42tg/Gartensauna/README.md

# Gartensauna – CAD & Selbstbau

Planung einer Gartensauna am Standort des bestehenden Holzunterstands. Dieses Repository ist die zentrale Quelle für Maße, Entscheidungen, CAD-Modelle, Bauaufbau, Kosten und Aufgaben.

## Verbindlicher Planungsstand (13.11.2026)

**Der alte Holzunterstand wird abgerissen; geplant wird ein Neubau. Seine 1,93 m Höhe begrenzen den Neubau nicht. Beschlossen sind 2,20 m lichte Innenhöhe, gemessen von Oberkante Fertigboden bis Unterkante fertiger Decke.**

Mit dem aktuellen 281-mm-Dachaufbau liegt die Dachoberkante bei 2,481 m über Fertigboden. Einschließlich 120 mm Bodenaufbau: 2,601 m von Bodenunterseite bis Dachoberkante, ohne Fundamente und zusätzliches Dachgefälle. Gelände- und Genehmigungshöhe bleiben zu bestimmen. Maßgebend: [Entscheidung 0012](docs/decisions/0012-neubau-innenhoehe.md).

## Gemessener Altbestand (25.10.2026)
- Bestehender Unterstand: **3,20 m lang**, **1,70 m tief** (links, Mitte und rechts), **1,93 m hoch** (gemessener Wert; Messpunkt noch zu klären).
- Eine Erweiterung der Tiefe auf **bis zu ca. 2,00 m** ist möglich.
- Der Unterstand wird **abgerissen**. Bestandsmaße dienen der Standortreferenz, nicht als maximale Neubauhöhe.
- Kein Umbau des Steinturms.
- Vorhandene Fotos zeigen einen Holzunterstand mit Pultdach, Pfosten, OSB-Teilen und Holzlager.

## Historischer Entwurf V1 (nicht maßgebend für den aktuellen Neubau)
Für CAD V1 werden **3,20 × 2,00 m** und eine **vordere Höhe von 2,30 m** als *Annahmen* verwendet, nicht als beschlossene Endmaße. Saunabänke, Tür und Ofen sind Platzhalter.

## Vorgehen
1. Bestandsmaße und Geländesituation vervollständigen.
2. Parametrisches CAD-Modell mit Varianten erstellen.
3. Grundriss, Ofen, Bänke und Lüftung festlegen.
4. Wand-, Dach- und Bodenaufbau bauphysikalisch prüfen.
5. Statik, Brandschutz, Elektroinstallation und lokale Anforderungen prüfen.
6. Stückliste, Kosten und Bauablauf ausarbeiten.

Siehe [Messwerte](docs/measurements.md), [Anforderungen](docs/requirements.md), [Entscheidungen](docs/decisions/README.md) und [Aufgaben](https://github.com/42tg/Gartensauna/issues).

## Visuelle Planung

Grundriss

Explosionsansicht

Wandaufbau

[Alle Zeichnungen](docs/visuals/README.md) · [Parametrisches OpenSCAD-Modell](cad/sauna.scad)

**Hinweis:** Das OpenSCAD-Modell ist ein neues Konzeptmodell, nicht die zuvor im Chat erwähnte FreeCAD-/STEP-Datei. Bauphysik und Konstruktion sind noch nicht freigegeben.

## Vorentwurf V2

[Maßgeprüfter Konzept- und Angebotsvorentwurf](docs/vorentwurf-v2.md) mit Schichttabelle, Mengengerüst, Bau- und Sicherheitsprüfpunkten. **Keine bauaufsichtliche, statische oder bauphysikalische Freigabe.**

## Aktueller Hauptentwurf: V3 L-Form

V3-Grundriss

- [V3: Konzept und offene Maßfragen](docs/vorentwurf-v3.md)
- [V3: parametrisches 3D-Konzept](cad/sauna-v3.scad)
- V2 bleibt als rechteckige Alternative erhalten. V3 ist noch nicht baufreigegeben.

## Lüftung und Strömungsvergleich

[Öffnungen, Modellannahmen und Kennzahlen](docs/construction/ventilation.md): CAD mit Zuluft, Abluft und Trocknungsklappe; automatisierter 3-D-Luftaltervergleich mit Varianten und Sensitivitätsprüfung. **Isothermes Orientierungsmodell, keine thermische Sauna-CFD.** Ergebnisse im Workflow [Ventilation comparison](https://github.com/42tg/Gartensauna/actions/workflows/ventilation.yml).

## Thermische CFD mit Wärmeauftrieb

[Modell, Prüfungen und Reproduktion](docs/construction/thermal-cfd.md): OpenFOAM berechnet Luftdichte, Temperatur, Auftrieb, Turbulenz und Oberflächenstrahlung gekoppelt. Acht Szenarien einschließlich Kontrollfall ohne Schwerkraft. **Nur numerisch qualifizierte Fälle vergleichen; Randbedingungen sind noch Annahmen.** [Workflow und Ergebnisse](https://github.com/42tg/Gartensauna/actions/workflows/thermal-ventilation.yml).

Zeitabhängige Wärmeauftriebsrechnung: [URANS, Zeitmittel und Zeitschrittprüfung](docs/construction/transient-cfd.md).

[Fünf Lüftungspositionen: Vergleichsplan und automatische Auswertung](docs/construction/ventilation-study.md).

## Vorläufige Vorraumbreite (13.11.2026)
Vorraum **1400 mm lichte Breite**, Nachmessung durch den Nutzer ausstehend (ADR 0013). Saunaflügel bleibt 2000 mm außen breit; daraus folgt **3605 mm Neubau-Gesamtbreite** mit bündiger Trennwand nach ADR 0014, zuzüglich Dachüberstand. 3200 mm bleibt das alte Bestandsmaß; Scan nicht umskalieren. Lichte Höhe weiterhin 2200 mm.

## Realitätscheck mit beiden Türen

[Prüfbericht und offene Punkte](docs/reality-check-2026-11-13.md) · [Bemaßter CAD-Grundriss](docs/visuals/grundriss-v3-bemasst.svg). Bündige 128,1-mm-Trennwand, beide Türschwenks geprüft; Bankaufstieg und Ofenauswahl weiterhin offen.

## Interaktive Web-Werkbank

Drei Tabs für bemaßte Zeichnungen, CAD-/Blender-Modell mit Explosion und Cutaway
sowie Umgebungsscan mit einblendbarer Sauna. Quellcode und lokale Build-Anleitung:
[web/README.md](web/README.md). Der CAD-Renderlauf liefert zusätzlich das
Artefakt `gartensauna-web`; private Scanaufnahmen sind nicht Bestandteil des Repos.
