42tg/Gartensauna/cad/README.md

# CAD

Ziel: Parametrisches FreeCAD-Modell mit editierbarer Geometrie, STEP-Export, Grundriss und Schnitten.

## Erste Parameter (mm)
- Länge: 3200 (Bestandsmaß)
- Tiefe: 1700 (Bestand), Variante 2000 (Planungsannahme)
- Höhe Bestand: 1930 (Messpunkt noch offen)
- Höhe vorne, Konzept V1: 2300 (Planungsannahme)

**Hinweis:** Die zuvor im Chat bereitgestellten CAD-Dateien sind noch nicht in diesem Repository. Nicht so tun, als seien sie hier versioniert.

## Im Repository vorhanden

- [sauna.scad](sauna.scad): editierbares OpenSCAD-Konzept mit Varianten für 1700/2000 mm Tiefe und montierter/Explosions-/Tragwerksansicht.
- [SVG-Zeichnungen](../docs/visuals/README.md): Grundriss, Explosionsansicht und Wandprinzip.

Das ursprünglich angekündigte FreeCAD-/STEP-Modell ist **noch nicht** im Repository. Das OpenSCAD-Modell ersetzt keine fachlich geprüfte Ausführungsplanung.
