42tg/Gartensauna/docs/decisions/README.md

# Entscheidungsprotokoll (ADRs)

Jede Entscheidung bekommt eine eigene Markdown-Datei mit Status, Datum, Kontext, Entscheidung und Folgen.

- [ADR-0001: Standort am Holzunterstand](0001-standort.md)

Offene Varianten gehören zunächst in Issues und sind **keine** beschlossenen Entscheidungen.

- [ADR-0012: Abriss und 2200 mm lichte Neubauhöhe](0012-neubau-innenhoehe.md) – maßgebend für den aktuellen Höhenbezug.

- [ADR-0013: Vorraum vorläufig 1400 mm licht](0013-vorraum-1400mm.md).
