42tg/Gartensauna/docs/requirements.md

# Anforderungen und Ziele

## Feststehend
- Gartensauna statt Steinturm.
- Standort: bisheriger Holzunterstand hinten im Garten.
- Geplante Konstruktion darf vollständig erneuert werden.
- Anschauliches parametrisches CAD-Modell und Schichtdarstellungen für Dämmung und Feuchteschutz.
- Dokumentation aller Entscheidungen und eine spätere Stückliste.

## Offen
- Tatsächliche Endabmessungen und Dachneigung
- Zwei getrennte Liegen (je 600 × 2100 mm) für zwei Liegende bzw. vier Sitzende sind festgelegt; Bankaufstieg bleibt offen.
- Ofentyp und Leistung
- Wand-/Dach-/Bodenaufbau
- Fundament, Belüftung und Entwässerung
- Türprodukte/Beschläge und Anschlüsse, Stromversorgung, Budget

## Beschlossener Neubau- und Höhenbezug (13.11.2026)
Altbestand wird abgerissen. Lichte Innenhöhe 2200 mm zwischen Fertigboden und fertiger Decke; 1930 mm Bestandshöhe begrenzt den Neubau nicht. Außenhöhe ergibt sich zusätzlich aus Boden-/Dachaufbau und dem noch offenen Geländebezug. Maßgebend: [Entscheidung 0012](decisions/0012-neubau-innenhoehe.md).

## Vorläufige Vorraumbreite (13.11.2026)
Vorraum **1400 mm lichte Breite**, Nachmessung durch den Nutzer ausstehend (ADR 0013). Saunaflügel bleibt 2000 mm außen breit; daraus folgt **3605 mm Neubau-Gesamtbreite** mit bündiger Trennwand nach ADR 0014, zuzüglich Dachüberstand. 3200 mm bleibt das alte Bestandsmaß; Scan nicht umskalieren. Lichte Höhe weiterhin 2200 mm.
