42tg/Gartensauna/docs/decisions/0006-zwei-liegeflaechen.md

# 0006 – Zwei gleich breite Liegeflächen

> Historischer Entscheidungsstand. Geometrie, Türen und aktuelle Breiten werden durch [ADR 0014](0014-trennwand-tueren-realitaetscheck.md) konkretisiert/korrigiert.
Datum: 2026-10-26. Nutzerziel: Zwei Personen sollen gleichzeitig liegen können; bei vier Personen überwiegend Sitzen.

Harvia empfiehlt mindestens 600 mm Tiefe zum Liegen und etwa 600 mm Banklänge je Sitzplatz:
https://www.harvia.com/en/ideas-and-trends/products/choosing-sauna-benches/
(abgerufen 26.10.2026). Das ist eine Planungsempfehlung, keine hier nachgewiesene private Bauvorschrift.

Entscheidung: je 600 × 2100 mm voll nutzbare Fläche, ohne Überdeckung. 600 mm ist der platzsparende Liegewert; breiter würde den ohnehin schmalen Gang weiter reduzieren. 2100 mm passen für Personen bis etwa 1900 mm mit 200 mm Längenreserve als Planungsannahme. Vier Personen können auf beiden Ebenen verteilt sitzen.

Die bisherige Verlängerung bis direkt zur Stirnwand kollidiert mit dem Ofenbereich, sobald die untere Bank verbreitert wird. Deshalb beginnen beide Liegen erst bei y=-1250 mm. Der vordere Abstand der unteren Bank zur konservativen Ofenhülle beträgt mindestens 235 mm; mehr als die angesetzten 150 mm. Die obere Bank liegt zusätzlich seitlich versetzt. Fenster-/Decken-/Bodenabstände des Ofens bleiben unverändert.

Damit der Einstieg sinnvoll bleibt, wurde die vorhandene 800-mm-Öffnung aus der Umkleide um 280 mm nach hinten auf y=650..1450 mm verschoben. Hinter den Bänken bleiben 670 mm, davon 600 mm unmittelbar vom Durchgang erreichbar. Gang an der Glasfront 545 mm. Die 410-mm-Engstelle neben der Trennwand ist nicht als Einstieg vorgesehen. Ofenbereich ist eine Sackgasse, kein Durchgang neben dem heißen Korb.

Alle Werte sind Modellmaße. Türflügel/Öffnungsrichtung, Aufstiegshilfe, Berührungsschutz, Belastbarkeit, Befestigung und finale Ofenauswahl bleiben offene Ausführungsdetails. Raumhülle und Bankhöhen bleiben unverändert. ADR 0005 ist hinsichtlich Bankabständen/Gang durch diese Entscheidung ersetzt. CI prüft volle Liegebreiten, gleiche Längen, fehlende Überdeckung und Ofenabstände an den importierten CAD-Außenhüllen.
