42tg/Gartensauna/docs/decisions/0013-vorraum-1400mm.md

# 0013 – Vorraum vorläufig 1400 mm licht

> Historischer Entscheidungsstand. Geometrie, Türen und aktuelle Breiten werden durch [ADR 0014](0014-trennwand-tueren-realitaetscheck.md) konkretisiert/korrigiert.

Status: vorläufige Planungsentscheidung, Aufmaß ausstehend. Datum: 13.11.2026.

Der Vorraum wird auf **1400 mm lichte Breite** zwischen fertiger Außenwand-Innenseite und fertiger Trennwandfläche erweitert. Der Nutzer misst die verfügbare Gesamtbreite noch nach. 1400 mm ist keine Außenbreite, kein Bestandsmesswert und kein Maß aus der Punktwolke.

Der Saunaflügel bleibt 2000 mm außen breit. Beide 600 × 2100 mm Liegeflächen, Ofen, Glasfront und Zuluft werden zusammen mit dem Flügel um 507,5 mm nach rechts verschoben; ihre gegenseitigen Abstände bleiben erhalten. Die ursprüngliche Bestandsbreite von 3200 mm bleibt in den Messdaten bestehen.

| Maß | Aktuelle Planung |
|---|---:|
| Vorraum lichte Breite | 1400 mm |
| Vorraum lichte Tiefe | 1290 mm |
| Außenwandaufbau | 205 mm |
| Flügelbeginn x | 1707,5 mm |
| Saunaflügel außen breit | 2000 mm |
| Neubau-Gesamtbreite | 3707,5 mm |
| Lichte Innenhöhe | 2200 mm (ADR 0012) |

CAD-Ableitung: `main_width = wing_width + changing_clear_width + 1.5*wall`. Der vorhandene Trennwandversatz ist darin berücksichtigt. 3707,5 mm beschreibt das parametrische Modell, keine Aufmaßgenauigkeit. Grob werden rund 3,71 m Außenbreite benötigt, zusätzlich zum Dachüberstand von je 80 mm.

Grundrissfläche außen steigt von 9,44 auf 10,30275 m²; rechnerischer Mehrbedarf für Boden/Decke 0,86275 m² vor Abzügen/Verschnitt. Außenumfang steigt von 13,80 auf 14,815 m; Bruttowandfläche bei 2,20 m Höhe um 2,233 m². Keine fertige Materialbestellliste. Dachfläche und Materialmengen aus dem erweiterten CAD neu ableiten.

Vor Ort verfügbare Breite, Grundstücksgrenzen und Dachüberstand noch prüfen. Bis dahin keine Ausführungsfreigabe. Der Scan behält seinen bisherigen Maßstab und wird nicht auf die größere Neubau-Breite gestreckt. Die Innengeometrie der Sauna bleibt bis auf Translation unverändert; vor Vergleich von Simulationen trotzdem deren Modellstand prüfen.

Aufmaß-Aufgabe: [Issue #9](https://github.com/42tg/Gartensauna/issues/9). Herstellervergleich: HUUM DROP 2.0 EU v6, Tabelle 1, am 13.11.2026 erneut gelesen; bestehende Abstandsprüfung bleibt erforderlich. Die reine Flügelverschiebung ändert keine Ofenabstände.
