42tg/Gartensauna/docs/decisions/0002-vollflaechige-glasfront.md

# 0002 – Vollflächige Glasfront zum Garten

Datum: 25.10.2026
Status: Nutzerentscheidung für den Entwurf

Die linke, zum Garten gerichtete Front des vorspringenden rechten Saunaflügels wird über ihre gesamte Breite bodentief bis zur Dachunterkante verglast. Das bisherige Fenster mit Brüstung und Wandstreifen entfällt. Die Fenstergröße folgt den CAD-Parametern `wing_extension` und `height`; aktuell 2.000 × 2.400 mm. Rahmen, Glasaufteilung und Lastabtragung bleiben offene Konstruktionsdetails.

## Fortschreibung 13.11.2026
Die damalige Höhenannahme von 2400 mm wird durch [Entscheidung 0012](0012-neubau-innenhoehe.md) ersetzt: 2200 mm lichte Innenhöhe. Die übrigen Festlegungen bleiben bestehen.
