42tg/Gartensauna/docs/decisions/0005-ofen-am-fenster.md

# 0005 – Ofen am Fensterbereich und Abstandsprüfung
Datum: 2026-10-26. Nutzerentscheidung: Ofen auf die andere Seite zum Fenster versetzen; Abstände bei Änderungen grundsätzlich mitprüfen.

## Umsetzung
Wandmontage an der Stirnwand neben der Glasfront, Mitte x=1700 mm, Montageebene y=-1820 mm, Unterkante z=310 mm. Drehung 180°, Vorderseite zeigt in den Raum. Form und Größe unverändert. Der normale Zugang von der Umkleide bleibt frei; der schmale Spalt zwischen Ofen und Bank ist kein Durchgang. In der Cutaway-Ansicht wird diese Montagewand ausgeblendet, die Halterung bleibt sichtbar.

## Herstellergrundlage
HUUM DROP 2.0 EU, Anleitung v6, Seiten 4–5 (Tabelle 1/Abbildung 1), abgerufen 2026-10-26:
https://huum.eu/wp-content/uploads/2026/01/DROP_2_0_User_Manual_EU_v6_WEB.pdf

Konservativ DROP 7/9: seitlich/vorn A mindestens 150 mm, über Ofen 1200 mm, unter Ofen 100 mm. E=310 mm bezeichnet die Montageplatte, NICHT die Ofenunterkante. Die Modellunterkante 310 mm bleibt als großzügigere Annahme bestehen. Gültigkeit der Herstellerabstände setzt korrekte Steinschichtung und vollständiges Originalgerät voraus.

## Modellprüfung
Konservative Außenhüllen, nicht der engere Abstand zwischen einzelnen Korbstäben:
- Fensterrahmen: mindestens 260 mm; Glasfläche: 274 mm.
- Untere Bank: 225 mm; obere Bank: 605 mm.
- Decke: 1500 mm; fertiger Boden: 310 mm.
- Regulärer Gang zwischen Rahmen und unterer Bank: 875 mm. Nur am Sackgassenende steht der Ofen; die 225-mm-Lücke neben ihm ist kein Laufweg.
- Halterung liegt an der Stirnwand; Position und Orientierung werden am exportierten Modell geprüft.
Die CI prüft diese Abstände an den tatsächlichen importierten CAD-Außenhüllen der Gesamtansicht. Ein geometrischer Check ersetzt keine Montagefreigabe, Glas-/Rahmenfreigabe, Berührungsschutz- oder Befestigungsplanung.

## Leistung bleibt offen
Innenraum näherungsweise 1,64 × 3,34 × 2,40 = 13,15 m³, ohne Abzug von Bänken. Sichtbares Glas 1,93 × 2,33 = 4,50 m². Mit Herstellerzuschlag 1 m³ je m² ungedämmter Glasfläche ergibt sich ca. 17,64 m³; selbst mit dieser günstigen Glasflächenannahme über 13 m³ (DROP 9). Deshalb keine Kaufempfehlung für die konkrete DROP-Variante. Ofenfamilie/Leistung und tatsächlicher Glasaufbau müssen vor Beschaffung neu bewertet werden. Siehe Issue #6.

## Fortschreibung 13.11.2026
Die obige Volumenrechnung beschreibt den damaligen Entwurf. Für den aktuellen Hüllaufbau und 2200 mm Innenhöhe siehe [Entscheidung 0012](0012-neubau-innenhoehe.md). Die Ofenauswahl bleibt offen.
