42tg/Gartensauna/docs/decisions/0003-sichtbare-materialschichten.md

# 0003 – Sichtbare Baumaterialien statt Blockmodell

25.10.2026 – Nutzerwunsch: realistische, aus CAD erzeugte Darstellung mit einzeln erkennbaren Brettern und Materialschichten. Das Bauteilmodell ergänzt das V3-Layout um reale Einzelgeometrien und prozedurale Blender-Materialien. Zusätzliche Dicken und Querschnitte sind unbestätigte Entwurfsannahmen; Details stehen in `docs/detailmodell.md`. Es entstehen Gesamtansicht, Explosionsansicht und eine separate Wandlagenstudie.
