42tg/Gartensauna/photos/README.md

# Bestandsfotos

Fotos des bestehenden Unterstands wurden im Chat bereitgestellt. Originaldateien hier ergänzen, sobald sie verfügbar sind. Möglichst mit Aufnahmerichtung und Datum beschriften.
