42tg/Gartensauna/docs/decisions/0011-lueftungspositionen-vergleichen.md

# ADR 0011: Fünf mechanische Lüftungsanordnungen vergleichen

Datum: 03.11.2026. Status: Vergleich beauftragt, Bauentscheidung offen.

Fünf geometrisch geprüfte virtuelle Varianten variieren einzeln die Abluftentfernung, Ablufthöhe und Zuluftposition. Der Bau-CAD-Stand bleibt bestehen. Alle Hauptläufe verwenden denselben Durchsatz, dieselbe Wärmeleistung und eine physikalische Stunde Rechenzeit. Nicht eingeschwungene Fälle werden nicht gewertet.

Zwei qualifizierte Finalisten werden unabhängig auf Gitter-, Zeit- und Betriebsbedingungsempfindlichkeit geprüft. Ein zweifelhafter oder umkehrender Vorteil bleibt als solcher sichtbar. Die Aussage wird ausdrücklich auf das vereinfachte Ofenmodell und die tatsächlich geprüften Finalisten begrenzt. [Plan und Freigabekriterien](../construction/ventilation-study.md).
