42tg/Gartensauna/docs/decisions/0001-standort.md

# ADR-0001: Standort am bisherigen Holzunterstand

- Datum: 2026-10-25
- Status: beschlossen

## Kontext
Der zuvor erwogene Steinturm ist zu klein und der Umbau wäre zu aufwendig.

## Entscheidung
Die Sauna wird am Standort des bisherigen Holzunterstands im hinteren Garten geplant. Die vorhandene Konstruktion kann bei Bedarf neu gebaut werden.

## Folgen
Bestandsmaße dienen als Referenz, begrenzen aber nicht zwingend Höhe oder Tiefe. Bestehende Bauteile dürfen erst nach Prüfung übernommen werden.
