42tg/Gartensauna/docs/vorentwurf-v2.md

# Vorentwurf V2 – Angebotsgrundlage (25.10.2026)

> **Status:** Konzept mit rechnerisch konsistenten Grundmaßen. Keine geprüfte Ausführungsplanung, kein verbindlicher Kostenvoranschlag. Die bisher gemessene Höhe von 1.930 mm ist ein Bestandsmaß, nicht die geplante neue Höhe.

## 1. Entwurfsentscheidung
Eigenständige Gartensauna am Standort des bisherigen Holzunterstands; Pultdach, Holzfassade, Glastür, zweistufige Bank und Elektroofen. Der Steinturm wird nicht verwendet. Der vorhandene Unterstand kann vollständig ersetzt werden.

| Eigenschaft | Bestandsaufnahme | Vorentwurf V2 |
|---|---:|---:|
| Breite | 3.200 mm | 3.200 mm |
| Tiefe | 1.700 mm | 2.000 mm |
| Höhe | 1.930 mm (Messpunkt offen) | 2.300 mm vorn, 2.200 mm hinten (Annahmen) |
| Wandgesamtstärke | unbekannt | 200,1 mm Beispielaufbau |
| lichte Innenbreite | – | ca. 2.800 mm |
| lichte Innentiefe | – | ca. 1.600 mm |
| lichte Innenfläche | – | ca. 4,48 m² |

**Maßprüfung:** 3.200 − 2 × 200 = 2.800 mm; 2.000 − 2 × 200 = 1.600 mm. Für 1.700 mm Bestandstiefe verbleiben nur 1.300 mm Innenmaß bei gleicher Wandstärke. Die Innenhöhe ist vor Klärung des Boden- und Dachaufbaus **nicht** freigegeben.

## 2. Beispielhafter Wandaufbau (innen → außen)

| Schicht | Dicke | Status |
|---|---:|---|
| Saunaprofilholz | 15 mm | Beispiel |
| Lattung / Installationsebene | 20 mm | Beispiel |
| Aluminium-Dampfsperre | 0,1 mm | Beispiel, Anschlüsse offen |
| Holzständer + geeignete Mineralwolle | 100 mm | Beispiel, Statik offen |
| Aussteifende Platte | 15 mm | **bauphysikalisch zu prüfen** |
| Hinterlüftung | 30 mm | Beispiel, Öffnungen/Anschlüsse offen |
| Außenholz | 20 mm | Beispiel |
| **Summe** | **200,1 mm** | nicht freigegeben |

Die Lage und Materialwahl der äußeren Aussteifung, Dampfsperrenanschlüsse, Luftdichtheit, Durchdringungen und Austrocknung müssen am Gesamtsystem nachgewiesen werden. **Nicht blind nach dieser Tabelle bauen.**

## 3. Dach, Boden, Ofen

- Dach: 100 mm Höhendifferenz über 2.000 mm Tiefe entsprechen 5 % Gefälle bzw. ca. 2,86°. Die Eignung der Dachdeckung und erforderliche Überstände sind noch zu prüfen.
- Dachtragwerk, Dämmung, Dampfsperre, Entwässerung und Schneelast: noch nicht dimensioniert.
- Boden: tragfähige Gründung, Spritzwasser-/Frostschutz und rutschhemmende Oberfläche festlegen; kein bereits bemessenes Fundament.
- Ofen: Elektro-Ofenplatzhalter. Sicherheitsabstände, Leistung, Leitungsquerschnitte, Schutzorgane und Lüftung erst mit Herstellerdaten und Elektrofachplanung festlegen.
- Bänke: obere Liegebank und untere Tritt-/Sitzbank als Konzept. Endgültige Höhen an nutzbare Innenhöhe und Ofen anpassen.

## 4. Mengengerüst (grobe Geometrie, keine Bestellung)

- Grundfläche: 3,20 × 2,00 = **6,40 m²**.
- Umfang: 2 × (3,20 + 2,00) = **10,40 m**.
- Brutto-Außenwandfläche überschlägig: 10,40 × 2,25 ≈ **23,4 m²**; Türöffnungen, Dachneigung und Überstände noch nicht abgezogen.
- Dachgrundfläche mindestens 6,40 m², tatsächliche Dachfläche inkl. Überständen größer.

## 5. Gewerke für Angebote
Rückbau/Entsorgung; Gründung/Boden; Holztragwerk; Außenhülle/Dach/Entwässerung; gedämmte Saunakabine; Saunabänke/Tür; Ofen/Steuerung/Lüftung; Elektroinstallation; Prüfung und Reserve.

**Kein belastbarer Euro-Preis**, bevor Gründung, konkrete Produkte, Ausführung und Leistungsumfang feststehen.

## 6. Prüfliste vor Baubeginn
1. Bestands- und Geländemaße, Grundstücksgrenzen.
2. Bau-/Abstandsrecht am Standort in Niedersachsen.
3. Statik: Gründung, Wind- und Schneelasten.
4. Bauphysik: Wand, Dach, Boden, Feuchteführung und Austrocknung.
5. Ofen- und Brandschutzabstände anhand Herstellerangaben.
6. Elektrik durch Elektrofachbetrieb.
7. Materialauswahl und vollständige Stückliste.

## 7. Zeichnungen und CAD
- [Grundriss](visuals/grundriss.svg)
- [Explosionsansicht](visuals/explosionsansicht.svg)
- [Wandschichten](visuals/wandaufbau.svg)
- [OpenSCAD-Entwurfsmodell](../cad/sauna.scad)

Zusätzlich existiert ein lokal erzeugter **fünfseitiger PDF-Vorentwurf** mit grafischem Grundriss, Explosionsdarstellung, Wandaufbau und Angebotsstruktur; er ist noch nicht als Binärdatei in GitHub eingecheckt.
