42tg/Gartensauna/BOM.md

# Stückliste / Bill of Materials

Noch keine freigegebene Stückliste. CAD-Geometrie und Materialentscheidungen stehen aus.

Konzept-V3: vollflächige Glasfront 2,00 × 2,40 m = 4,80 m² Brutto-Ansichtsfläche. Kein Bestellmaß; Rahmen, Teilung und Glasaufbau offen.

## Detailliertes Materialmodell
34 CAD-Bauteilgruppen für Betonauflager, Boden, Wandlagen, Dachlagen, Bänke, Stuhl und Glasfront. Sämtliche zusätzlichen Material- und Querschnittsannahmen stehen in [detailmodell.md](docs/detailmodell.md). Keine freigegebene Bestell- oder Zuschnittliste.

## Ofen als visuelle Referenz
1 × wandhängender HUUM-DROP-artiger Ofen, 390 × 335 × 590 mm; getrennte CAD-Gruppen für Edelstahlkorb, Halterung und Steine. Hersteller nennt 55 kg Steinfüllung; modellierte Steine sind nur illustrative Geometrie, keine Mengenberechnung. Leistung, Steuerung und Montage nicht festgelegt; siehe ADR 0004.

## Liegebänke (Konzeptstand 26.10.2026)
2 × Liegebank 600 × 2100 mm, je acht gleich breite Lamellen mit sieben 5-mm-Fugen; rechnerische Lamellenbreite 70,625 mm und Dicke 28 mm. Fertigungsquerschnitte, Unterbau und Belastbarkeit noch nicht freigegeben. Layout siehe ADR 0006.

## Hüllaufbau V3.1

Wand: 19-mm-Innenholz, 20-mm-Lattung, Alu-Bahn, 100-mm-Ständer/Dämmung, Windbahn, 15-mm-Außenplatte, 30-mm-Fassadenlattung, 20-mm-Außenholz; Modellgesamtmaß 205 mm. Dach: 15-mm-Untersicht, 20-mm-Lattung, Alu, 160-mm-Dämmzone, Windbahn, 60-mm-Lüftungsreserve, 22-mm-Schalung, 3-mm-Dachhaut; insgesamt 281 mm. Materialprodukte und Mengen nicht bestellfertig; [Details](docs/construction/insulation.md).

## Lüftung – Planungspositionen (03.11.2026)
- 1 Zuluftdurchführung, klare Öffnung 150 × 80 mm, regelbares Ventil/Verteiler noch auszulegen.
- 1 Abluftdurchführung, klare Öffnung 300 × 160 mm; mechanische Absaugung, Planungsfälle 60/80/100 m³/h tatsächlicher Durchsatz.
- 1 verschließbare Trocknungsdurchführung, klare Öffnung 300 × 160 mm.
- Jeweils Hülsen, hitze-/feuchtegeeignete Gitter, Abdichtungen, Wetterschutz; Ventilator/Kanäle/Kondensatführung noch auszulegen. CAD-Hülsen/Gitter sind Konzeptbauteile, keine Einkaufsspezifikation.
