42tg/Gartensauna/docs/costs.md

# Kostenübersicht

Noch keine belastbare Kostenschätzung. Kostenpositionen nach Festlegung der Konstruktion und Stückliste ergänzen.
