42tg/Gartensauna/cad/bench-layout.scad

// Shared active bench layout, mm. Two fully exposed 600 x 2100 lying surfaces.
bench_depth = 600;
bench_length = 2100;
bench_gap = 20;
bench_wall_gap = 10;
bench_upper_x = main_width-wall-bench_wall_gap-bench_depth;
bench_lower_x = bench_upper_x-bench_gap-bench_depth;
bench_start_y = -1280;
bench_upper_z = 947;
bench_lower_z = 507;
sauna_door_y = 580; // rough opening; clear y=620..1420
sauna_door_width = 800; // nominal frame clearance
