42tg/Gartensauna/cad/layout-metadata.scad

include <sauna-detailed.scad>
echo(["layout",main_width,main_depth,wing_start_x,wing_extension,wall,partition_t,height,roof_thickness]);
echo(["benches",bench_lower_x,bench_upper_x,bench_start_y,bench_depth,bench_length,bench_lower_z+28,bench_upper_z+28]);
echo(["doors",sauna_hinge,entrance_hinge,door_leaf_width,sauna_door_y,entrance_door_x,door_clear_width,door_clear_height,door_rough_width,door_rough_height]);
