42tg/Gartensauna/(list of files, cad)

Other CAD files:
cad/sauna.scad
