42tg/Gartensauna/docs/decisions/0007-huellaufbau.md

# 0007 – Hüllaufbau konkretisieren

26.10.2026: Nutzer beauftragt Konkretisierung anhand der besprochenen Schichtmaße. Planungswahl: 205 mm Außenwand, 100 mm Wanddämmung, 160 mm Dachdämmung, 281 mm Dach-Gesamtreserve. Außenumriss und 2400 mm Innenhöhe bleiben erhalten; zwei freie 600 × 2100 mm Liegeflächen ebenfalls. Ofen folgt der Innenkante der Stirnwand. Horizontale Holzbekleidungen auf vertikalen Latten statt bislang unterbrochener vertikaler Luftwege.

Maßfolgen, Schichttabelle, Quellen und offene Punkte: [Hüllaufbau](../construction/insulation.md). Keine Bau-, Tragwerks- oder Montagefreigabe. Historische ADRs 0005/0006 behalten ihre damaligen Maße; aktuelle Abstände stehen im Hüllaufbau und CI-Bericht.

## Fortschreibung 13.11.2026
Die damalige Höhenannahme von 2400 mm wird durch [Entscheidung 0012](0012-neubau-innenhoehe.md) ersetzt: 2200 mm lichte Innenhöhe. Die übrigen Festlegungen bleiben bestehen.
