42tg/Gartensauna/docs/construction/foundation.md

# Boden und Fundament

**Offen:** Tragfähiger Untergrund, Fundamentart, Spritzwasserschutz, Bodenaufbau, Entwässerung und gegebenenfalls Dämmung.
