42tg/Gartensauna/docs/construction/roof.md

# Dach

**Offen:** Neue Dachhöhe, Dachneigung, Tragwerk, Dachhaut, Dämmung, Feuchteführung, Abstände und Entwässerung. Vorhandenes Pultdach dient als gestalterischer Ausgangspunkt.
