42tg/Gartensauna/docs/construction/walls.md

# Wände

**Offen:** Holzständerquerschnitte, Dämmstärke, Innenbekleidung, Hinterlüftung, Außenbekleidung und Wandanschlüsse.
