42tg/Gartensauna/docs/measurements.md

# Bestandsaufnahme

Stand: 25.10.2026. Alle Maße ungefähr, sofern nicht anders angegeben.

| Eigenschaft | Wert | Status |
|---|---:|---|
| Länge des Unterstands | 3.200 mm | vor Ort gemessen, ungefähr |
| Tiefe links | 1.700 mm | vor Ort gemessen |
| Tiefe Mitte | 1.700 mm | vor Ort gemessen |
| Tiefe rechts | 1.700 mm | vor Ort nachgemeldet |
| Höhe | 1.930 mm | vor Ort gemessen; genaue Position unklar |
| Mögliche künftige Tiefe | bis ca. 2.000 mm | Option |
| Neubau: lichte Innenhöhe | 2.200 mm | beschlossen am 13.11.2026; Fertigboden bis fertige Deckenunterseite |

## Abgrenzung zum Neubau
Der alte Schuppen wird abgerissen. Seine 1.930 mm Höhe sind ausschließlich ein historisches Bestandsmaß, keine Obergrenze für den Neubau. Der Scan zeigt auch abzubrechende Teile und darf nicht als verbleibende Bauhülle interpretiert werden. Bleibende Umgebung und Gelände dienen der räumlichen Einordnung. Die 2.200 mm sind keine Außenhöhe; siehe [Höhenentscheidung](decisions/0012-neubau-innenhoehe.md).

## Noch messen
- Dachhöhe vorne/hinten und genaue Bezugspunkte
- Pfostenpositionen, Abstände und Querschnitte
- Fundament/Bodenhöhen und Gefälle
- Abstand zu Mauer, Bewuchs und Grundstücksgrenzen
- Zugang, Türanschlag und verfügbare Anschlüsse

Fotos wurden im Chat bereitgestellt; noch nicht ins Repository übernommen.

## Vorläufige Vorraumbreite (13.11.2026)
Vorraum **1400 mm lichte Breite**, Nachmessung durch den Nutzer ausstehend (ADR 0013). Saunaflügel bleibt 2000 mm außen breit; daraus folgt **3605 mm Neubau-Gesamtbreite** mit bündiger Trennwand nach ADR 0014, zuzüglich Dachüberstand. 3200 mm bleibt das alte Bestandsmaß; Scan nicht umskalieren. Lichte Höhe weiterhin 2200 mm.
