42tg/Gartensauna/(commit log)

2026-10-25 docs: initialize sauna project - BOM.md
2026-10-25 docs: initialize sauna project - cad/README.md
2026-10-25 feat: add visual CAD concept cad/sauna.scad
    [sauna.scad]
2026-10-25 feat: add visual CAD concept docs/visuals/grundriss.svg
2026-10-25 feat: add visual CAD concept docs/visuals/explosionsansicht.svg
2026-10-25 feat: add visual CAD concept docs/visuals/wandaufbau.svg
2026-10-25 feat: add visual CAD concept docs/visuals/README.md
2026-10-25 docs: link visual concept and clarify CAD status
2026-10-25 feat: introduce L-shaped V3 sauna concept
    [sauna-v3.scad]
2026-10-25 docs: mark L-shaped V3 as current main concept
2026-10-25 fix: move V3 garden glazing to left side of sauna wing
2026-10-25 docs: record garden-facing glazing on left of sauna wing
2026-10-25 feat: add reproducible CAD-to-Blender pipeline
2026-10-25 fix: make CAD V3 part-selectable for Blender mesh export
    [sauna-v3.scad]
2026-10-25 ci: render CAD meshes and Blender views on main
2026-10-25 fix: generate and validate CAD-derived Blender previews and exploded view
    [sauna-v3.scad]
2026-10-25 feat: glaze entire garden-facing sauna front from floor to roof
    [sauna-v3.scad]
2026-10-25 feat: model individual construction layers and render timber, insulation and glass
    [sauna-detailed.scad]
2026-10-25 docs: require embedded CAD previews including exploded and cutaway views
2026-10-25 Model HUUM DROP-inspired stone heater from CAD and render close-up
    [heater-drop.scad, sauna-detailed.scad]
2026-10-25 Verify 29 CAD groups and heater dimensions in render artifacts
2026-10-26 Move heater beside glazing and verify manufacturer clearances
    [heater-drop.scad]
2026-10-26 Bound Blender package installation waits after stalled runner
2026-10-26 Provide two equal 600 mm lying benches with heater clearance and rear access
    [bench-layout.scad, sauna-detailed.scad, sauna-v3.scad]
2026-10-26 Show door openings in CAD-derived bench floor plan
    [sauna-detailed.scad]
2026-10-26 ci: only auto-render when CAD files change
2026-10-26 Konkretisiere Hüllaufbau: 205 mm Wand und 160 mm Dachdämmung
    [envelope.scad, heater-drop.scad, sauna-detailed.scad, sauna-v3.scad]
2026-10-26 Sichere Laufwege bei Änderungen am Hüllaufbau bereits im CAD ab
    [sauna-v3.scad]
2026-10-28 ci: shorten CAD handoff retention while preserving complete downloads (#7)
2026-11-03 Add CAD ventilation openings and conservative 3D airflow-age comparison
    [sauna-detailed.scad, sauna-v3.scad, ventilation-metadata.scad, ventilation.scad]
2026-11-03 Implement coupled thermal OpenFOAM CFD with buoyancy, radiation and conservation audits
2026-11-03 Audit thermal boundary fluxes and show full temperature range through inlet
2026-11-03 Record thermal CFD verification and unresolved stationary-flow convergence
2026-11-13 Set 2200 mm clear interior height and document demolition and height datums
    [sauna-v3.scad, ventilation.scad]
2026-11-13 Widen changing room to provisional 1400 mm clear width and parameterize wing placement
    [heater-drop.scad, sauna-detailed.scad, sauna-v3.scad, ventilation.scad]
2026-11-13 Regenerate CAD floor plan for 1400 mm clear changing room
2026-11-13 Correct flush partition, model both outward-opening doors and audit usable geometry
    [bench-layout.scad, doors.scad, layout-metadata.scad, sauna-detailed.scad, sauna-v3.scad, ventilation-metadata.scad]
2026-11-13 Document recalculated limits, dimensioned door plan and CAD swing cross-checks
2026-11-13 Eliminate clipped edge supports and verify full substructure STL components
    [sauna-detailed.scad]
2026-11-13 Fix phantom cutaway facades and validate evaluated Blender wall geometry
    [sauna-detailed.scad]
2026-11-14 Add interactive sauna workbench with CAD drawings, exploded Blender model and private scan support
